RoboticsBrno/RB0003-YellowMotorBoard/README.md

# RB0003-YellowMotorBoard
Motor board with encoder sensors for yellow motor.
