RoboticsBrno/RB0003-YellowMotorBoard/hw/YellowMotorEncoder_v2.0/YellowMotorEncoder_v2.0.kicad_pcb

## KiCad design hw/YellowMotorEncoder_v2.0/YellowMotorEncoder_v2.0.kicad_pcb (2020-10-14)

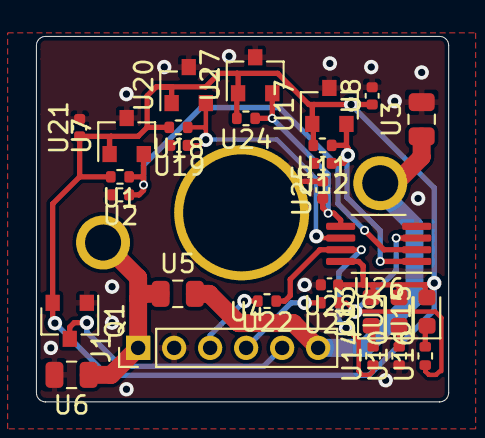
[picture p1: board YellowMotorEncoder_v2.0.kicad_pcb from above]

Board: 2 copper layers, 22.9 x 20.3 mm, 30 parts (0 on the bottom side), 16 nets.

Parts:
J1: Conn_01x06; PinHeader_1x06_P2.00mm_Vertical
Q1: AO3401A; SOT-23
U1, U11, U18, U24: 47k; R_0402_1005Metric
U2, U12, U19, U25: 18p/50V; C_0402_1005Metric
U3, U5, U6: 330n/50V; C_0805_2012Metric
U4: YELLOW_MOTORV2; MDCM
U7, U17, U20, U27: MH253ESO; SOT-23
U8, U21, U28: 22n/50V; C_0402_1005Metric
U9: GREEN; LED_0603_1608Metric
U10, U14, U16: 10k; R_0402_1005Metric
U13, U15: BLUE; LED_0603_1608Metric
U22, U23: 200; R_0402_1005Metric
U26: SN74LVC2G86DCTR; MSOP-8_3x3mm_P0.65mm

Connections:
/A: J1.3, U22.2
/A0: U1.1, U2.1, U7.2, U26.2
/A1: U11.1, U12.1, U17.2, U26.1
/B: J1.4, U23.2
/B0: U18.1, U19.1, U20.2, U26.6
/B1: U24.1, U25.1, U26.5, U27.2
/M+: J1.6, U3.1, U4.2, U5.2
/M-: J1.1, U4.1, U5.1, U6.1
/~A: U14.1, U22.1, U26.7
/~B: U16.1, U23.1, U26.3
GND: J1.2, Q1.1, U2.2, U3.2, U4.gnd, U6.2, U7.3, U8.2, U10.1, U12.2, U17.3, U19.2, U20.3, U21.2, U25.2, U26.4, U27.3, U28.2
unnamed: J1.5, Q1.3
unnamed: U9.1, U10.2
unnamed: U13.1, U14.2
unnamed: U15.1, U16.2
VCC: Q1.2, U1.2, U7.1, U8.1, U9.2, U11.2, U13.2, U15.2, U17.1, U18.2, U20.1, U21.1, U24.2, U26.8, U27.1, U28.1
