RoboticsBrno/RB0003-YellowMotorBoard/hw/YellowMotorEncoder_v1.1/YellowMotorEncoder.brd

## EAGLE design hw/YellowMotorEncoder_v1.1/YellowMotorEncoder.brd (2020-10-14, an earlier design)

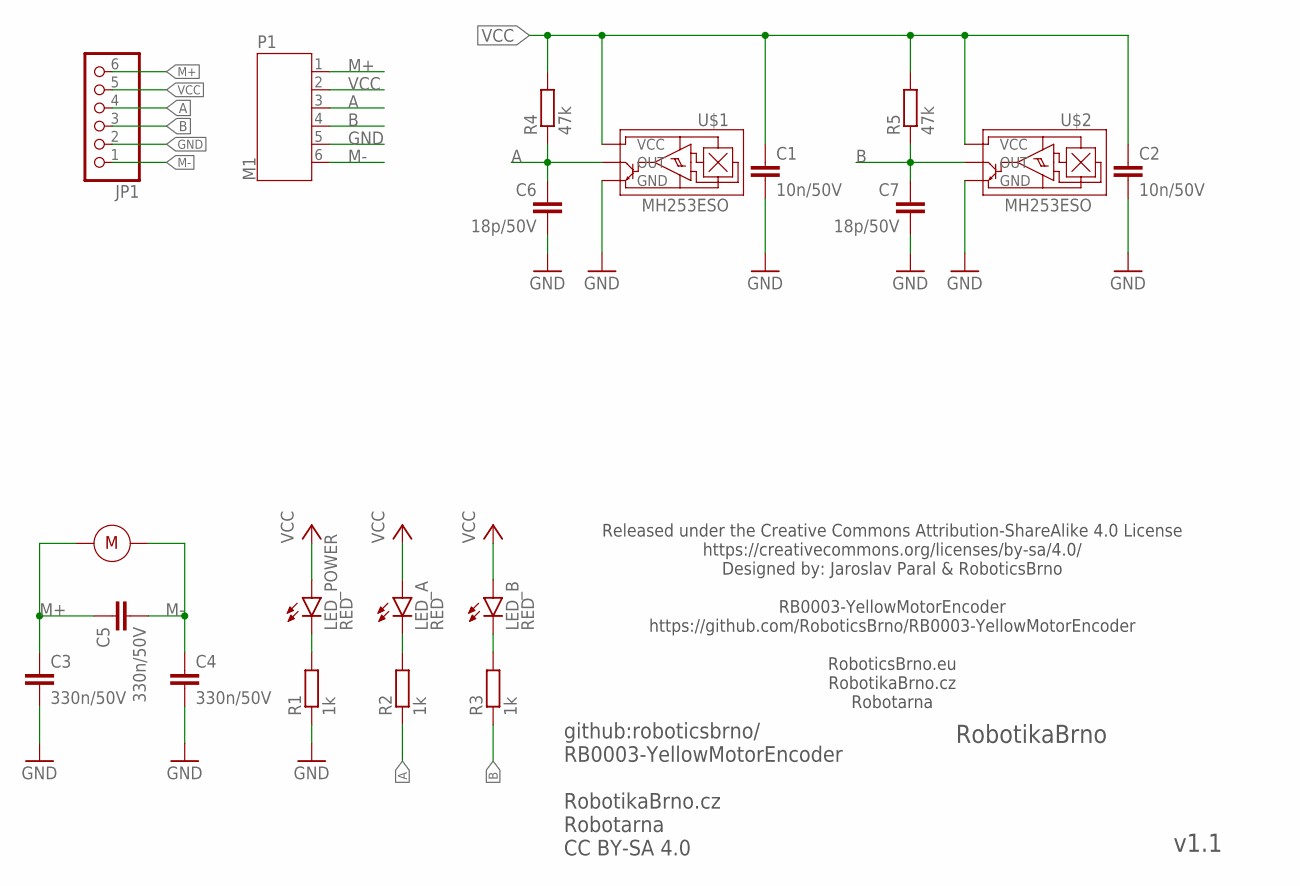
[picture p3: schematic YellowMotorEncoder.sch]

Parts:
C1, C2: 10n/50V; C0402; LCSC_ID C15195
C3, C4, C5: 330n/50V; C0805; LCSC_ID C1740
C6, C7: 18p/50V; C0402; LCSC_ID C1549
JP1: PINHD-1X6; 1X06
LED_A: RED; CHIPLED_0603; DIGIKEY 160-1446-1-ND
LED_B: RED; CHIPLED_0603; DIGIKEY 160-1446-1-ND
LED_POWER: RED; CHIPLED_0603; DIGIKEY 160-1446-1-ND
P1: M1; JST-PH6
R1, R2, R3: 1k; R0603; LCSC_ID C21190
R4, R5: 47k; R0603; LCSC_ID C25819
U$1, U$2: MH253ESO; SOT23
U$3: YELLOW_MOTOR

Connections:
A: C6.1, JP1.4, P1.3, R2.1, R4.1, U$1.2 (OUT)
B: C7.1, JP1.3, P1.4, R3.1, R5.1, U$2.2 (OUT)
GND: C1.2, C2.2, C3.2, C4.2, C6.2, C7.2, JP1.2, P1.5, R1.1, U$1.3 (GND), U$2.3 (GND)
LED_POWER: LED_POWER.C, R1.2
LED_SIDE1: LED_A.C, R2.2
LED_TOP1: LED_B.C, R3.2
M+: C3.1, C5.1, JP1.6, P1.1, U$3.P$2
M-: C4.1, C5.2, JP1.1, P1.6, U$3.P$1
VCC: C1.1, C2.1, JP1.5, LED_A.A, LED_B.A, LED_POWER.A, P1.2, R4.2, R5.2, U$1.1 (VCC), U$2.1 (VCC)

Notes on the sheet:
github:roboticsbrno/ RB0003-YellowMotorEncoder RobotikaBrno.cz Robotarna CC BY-SA 4.0
RobotikaBrno
v1.1
Released under the Creative Commons Attribution-ShareAlike 4.0 License https://creativecommons.org/licenses/by-sa/4.0/ Designed by: Jaroslav Paral & RoboticsBrno RB0003-YellowMotorEncoder https://github.com/RoboticsBrno/RB0003-YellowMotorEncoder RoboticsBrno.eu RobotikaBrno.cz Robotarna

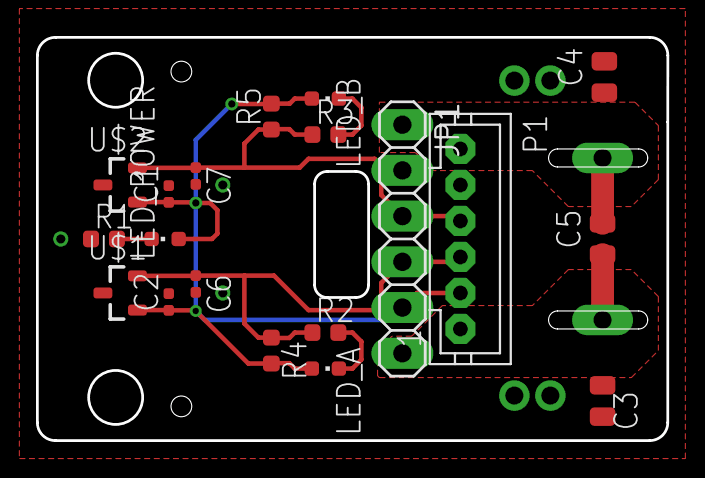
[picture p4: board hw/YellowMotorEncoder_v1.1/YellowMotorEncoder.brd from above]

Board: 2 copper layers, 35.0 x 22.4 mm, 20 parts (0 on the bottom side), 9 nets.
