RoboticsBrno/RB0003-YellowMotorBoard/hw/YellowMotorEncoder.brd

## EAGLE design hw/YellowMotorEncoder.brd (2020-10-14)

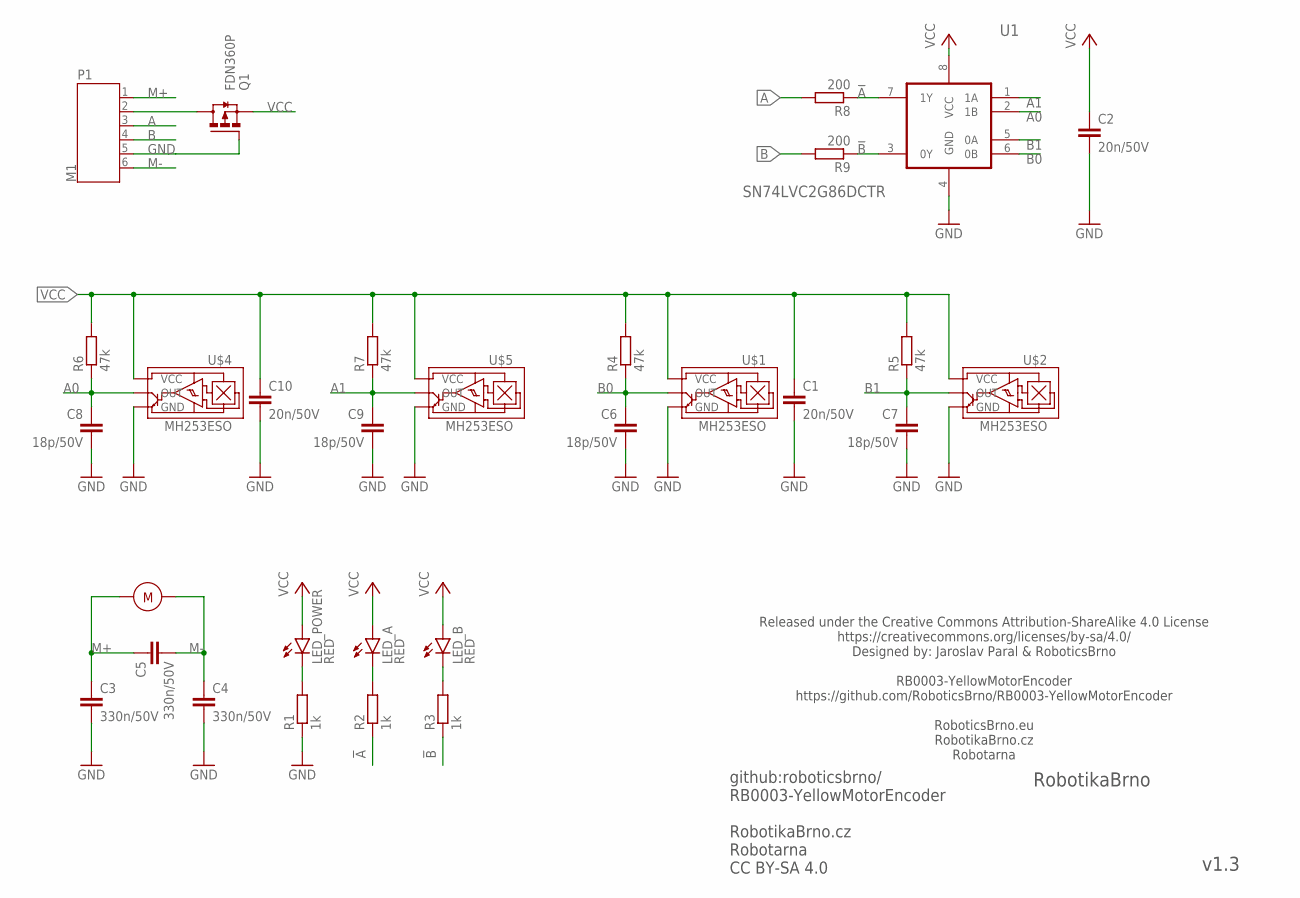
[picture p5: schematic YellowMotorEncoder.sch]

Parts:
C1, C2, C10: 20n/50V; C0402; LCSC_ID C15195
C3, C4, C5: 330n/50V; C0805; LCSC_ID C1740
C6, C7, C8, C9: 18p/50V; C0402; LCSC_ID C1549
LED_A: RED; CHIPLED_0603; DIGIKEY 160-1446-1-ND
LED_B: RED; CHIPLED_0603; DIGIKEY 160-1446-1-ND
LED_POWER: RED; CHIPLED_0603; DIGIKEY 160-1446-1-ND
M1: YELLOW_MOTORV2; YELLOW_MOTOR_V2
P1: M1; JST-PH6
Q1: FDN360P; SUPER-SOT3
R1, R2, R3: 1k; R0402; LCSC_ID C21190
R4, R5, R6, R7: 47k; R0402; LCSC_ID C25819
R8, R9: 200; R0402; LCSC_ID C25819
U1: SN74LVC2G86DCTR; SOP65P400X130-8N
U$1, U$2, U$4, U$5: MH253ESO; SOT23

Connections:
!A: R2.1, R8.1, U1.7 (1Y)
!B: R3.1, R9.1, U1.3 (0Y)
A: P1.3, R8.2
A0: C8.1, R6.1, U1.2 (1B), U$4.2 (OUT)
A1: C9.1, R7.1, U1.1 (1A), U$5.2 (OUT)
B: P1.4, R9.2
B0: C6.1, R4.1, U1.6 (0B), U$1.2 (OUT)
B1: C7.1, R5.1, U1.5 (0A), U$2.2 (OUT)
GND: C1.2, C2.2, C3.2, C4.2, C6.2, C7.2, C8.2, C9.2, C10.2, P1.5, Q1.1 (G), R1.1, U1.4 (GND), U$1.3 (GND), U$2.3 (GND), U$4.3 (GND), U$5.3 (GND)
LED_POWER: LED_POWER.C, R1.2
LED_SIDE1: LED_A.C, R2.2
LED_TOP1: LED_B.C, R3.2
M+: C3.1, C5.1, M1.P$1, P1.1
M-: C4.1, C5.2, M1.P$2, P1.6
unnamed: P1.2, Q1.3 (D)
VCC: C1.1, C2.1, C10.1, LED_A.A, LED_B.A, LED_POWER.A, Q1.2 (S), R4.2, R5.2, R6.2, R7.2, U1.8 (VCC), U$1.1 (VCC), U$2.1 (VCC), U$4.1 (VCC), U$5.1 (VCC)

Notes on the sheet:
github:roboticsbrno/ RB0003-YellowMotorEncoder RobotikaBrno.cz Robotarna CC BY-SA 4.0
RobotikaBrno
v1.3
Released under the Creative Commons Attribution-ShareAlike 4.0 License https://creativecommons.org/licenses/by-sa/4.0/ Designed by: Jaroslav Paral & RoboticsBrno RB0003-YellowMotorEncoder https://github.com/RoboticsBrno/RB0003-YellowMotorEncoder RoboticsBrno.eu RobotikaBrno.cz Robotarna

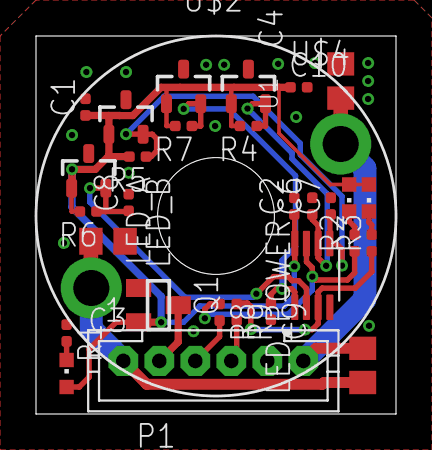
[picture p6: board hw/YellowMotorEncoder.brd from above]

Board: 2 copper layers, 20.0 x 21.0 mm, 30 parts (0 on the bottom side), 16 nets.
