RoboticsBrno/RB0003-YellowMotorBoard/(commit log)

2020-05-08 Add YellowMotorBoard board
    - need to finish routing
    [YellowMotorEncoder.brd, YellowMotorEncoder.sch]
2020-05-08 Finish routing of the board
    [YellowMotorEncoder.brd, YellowMotorEncoder.sch]
2020-05-09 Finish routing YellowMotorEncoder v1.0
    - route PCB
    - correct position of mounting holes
    - fix connectors signal
    [YellowMotorEncoder.brd, YellowMotorEncoder.sch]
2020-05-11 Swap encoder power polarity
    [YellowMotorEncoder.brd, YellowMotorEncoder.sch]
2020-05-11 Fixed LEDs orientation
    [YellowMotorEncoder.brd, YellowMotorEncoder.sch]
2020-05-11 Rerouted board
    [YellowMotorEncoder.brd]
2020-05-11 Improve layout for manufacturing
    - add JLC order number to silkscreen
    - add JLC tooling holes
    - fix rotation of hall sensors (`hall_sensor.lbr`)
    - decrease size of silkscreen text- board name, version, licence and URL
    [YellowMotorEncoder.brd, YellowMotorEncoder.sch]
2020-05-24 Add and move motor polygons
    - add bottom polygons for motor pins/soldering holes
    - move unmask polygons for motor pads to not overlap with M+/M-
    [YellowMotorEncoder.brd]
2020-05-24 Create folder `YellowMotorBoard_v1.0` with manufactured Eagle PCB files
    [YellowMotorEncoder.brd, YellowMotorEncoder.sch]
2020-05-24 Create version 1.1 - change shape of the motor holes/pads
    - create folder `YellowMotorBoard_v1.1` with manufactured Eagle PCB files
    - shape of motor holes (slotted holes) create according these tutorials
    - https://www.autodesk.com/products/eagle/blog/what-you-didnt-know-about-eagle-slotted-holes/
    - http://blog.snapeda.com/2019/05/30/how-snapeda-creates-slotted-holes-on-eagle/
    - `YellowMotorEncoder_JLCPCB.cam`
    - add Milling (46) layer
    - remove Document (48) layers
    [YellowMotorEncoder.brd, YellowMotorEncoder.sch]
2020-06-14 Make many improvements according testing v1.0 and v1.1 boards
    - increase version number from v1.1 to v1.2
    - decrease width of board from 22.4 to 22.2 mm
    - move all parts to corresponding position with respect to the board center
    - move hall sensor:
    - Y axis: 0.25 mm closer to the center of board (distance between both sensors is -0.5 mm)
    - X axis: 0.8 mm in motor direction
    - improve documetation texts
    - increase size, add some labels
    [YellowMotorEncoder.brd, YellowMotorEncoder.sch]
2020-06-15 Add Kicad export and KiKit panelizer makefile
    - fix position of text labels "A", "B"
    - export project to Kicad and panelize with KiKit
    - add configuration for TravisCI web page build
    [YellowMotorEncoder.brd, YellowMotorEncoder.kicad_pcb]
2020-06-22 Improve Makefile and add F.Mask polygon to kicad_export board
    [YellowMotorEncoder.kicad_pcb]
2020-06-24 Update shape of motor's slotted holes in Kicad exported board
    - change the shape from circle to oval as this feature is supported in Kicad
    - fix missing capacitor in KiKit export - move their label inside PCB border
    [YellowMotorEncoder.kicad_pcb]
2020-06-26 Release/manufacture version 1.2
    Summary:
    - decrease width of the board from 22.4 to 22.2 mm
    - Y axis: 0.25 mm closer to the centre of the board (distance between both sensors is -0.5 mm)
    - move slotted holes for motor contact soldering approx. 0.5 mm far from hall sensors for better assembly
    - add Kicad PCB file `YellowMotorEncoder.kicad_pcb` which was created from the Eagle files
    - use for panelizing with KiKit tool
    - modify slotted holes shape from a circle to oval as this feature is supported in Kicad
    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
    [YellowMotorEncoder.brd, YellowMotorEncoder.kicad_pcb, YellowMotorEncoder.sch]
2020-10-14 YellowMotorEncoder_V2.0
    New design with four sensors and xor to combine two signals to one.
    Design is in KiCad.
    [YellowMotorEncoder.brd, YellowMotorEncoder.kicad_pcb, YellowMotorEncoder.sch, YellowMotorEncoder_v2.0.kicad_pcb, YellowMotorEncoder_v2.0.sch]
2020-10-14 3D_viewer
    i add 3d model of motor and connector
    [YellowMotorEncoder_v2.0.kicad_pcb, YellowMotorEncoder_v2.0.sch]
