RoboticsBrno/RB0003-YellowMotorBoard/(notices)

Notices in the files:
hw/kicad_export/YellowMotorEncoder.kicad_pcb:
v1.2 CC BY-SA 4.0
hw/YellowMotorEncoder_v1.0/YellowMotorEncoder.brd:
v1.0 CC BY-SA 4.0
hw/YellowMotorEncoder_v1.1/YellowMotorEncoder.brd:
v1.1 CC BY-SA 4.0
